sachinpullil/mecanum-robot-meam-5100/Images/motor-driver-circuit.png

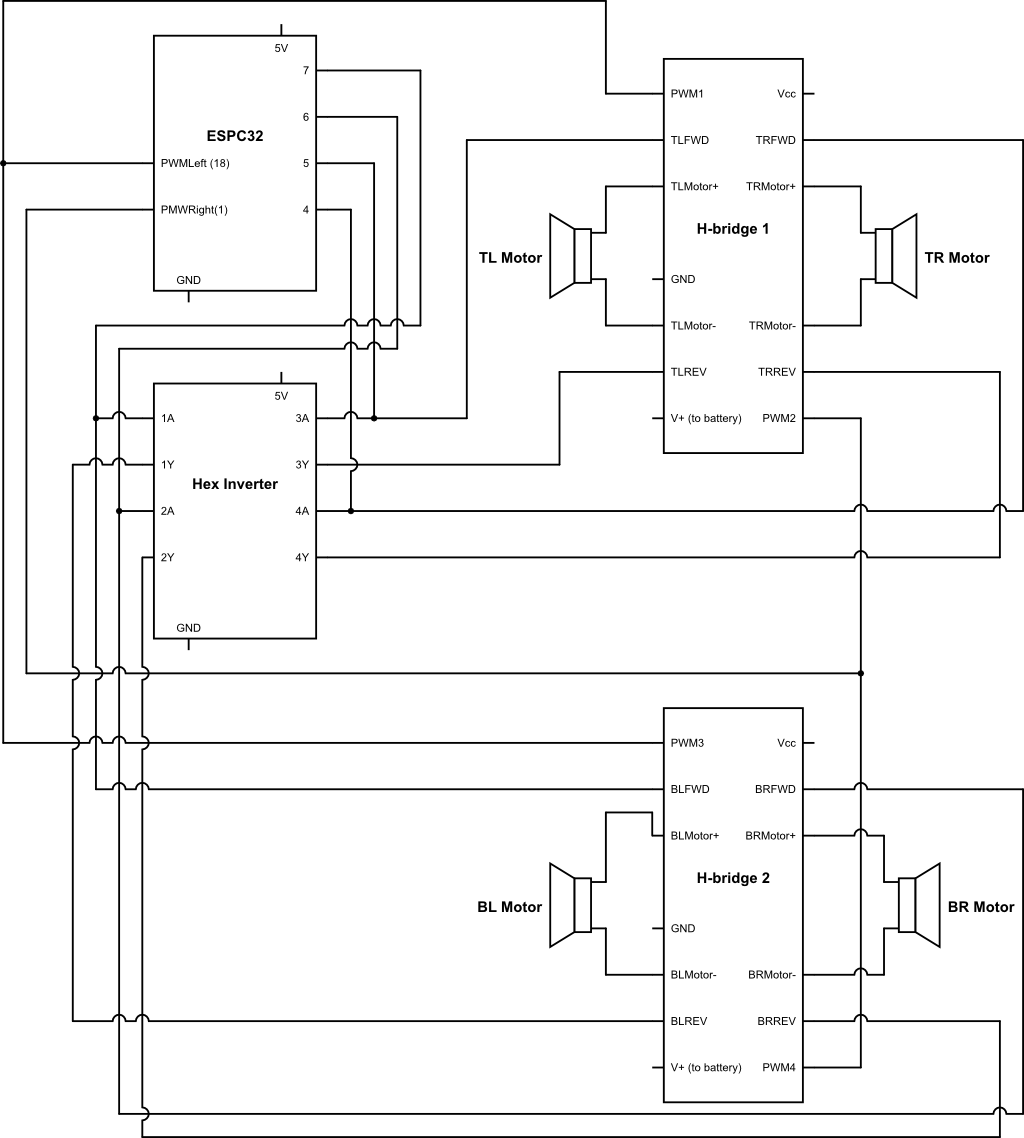
Images/motor-driver-circuit.png
