sachinpullil/mecanum-robot-meam-5100/Mecanum_robot_2.3_C3_MotorDriver/myi2csetup.h

/* i2c_slave_test - Example
 *  Slave i2c expecting slave ESP32 on i2c_master_test
 *  modified from 
   https://github.com/espressif/esp-idf/tree/master/examples/peripherals/i2c/i2c_self_test
   For other examples please check:
   https://github.com/espressif/esp-idf/tree/master/examples

    Attach SCL wire to GPIO 26, and  SDA to GPIO 25
   
   See README.md file to get detailed usage of this example.
   This example code is in the Public Domain (or CC0 licensed, at your option.)
   Unless required by applicable law or agreed to in writing, this
   software is distributed on an "AS IS" BASIS, WITHOUT WARRANTIES OR
   CONDITIONS OF ANY KIND, either express or implied.
*/
#include <stdio.h>
#include "esp_log.h"
#include "driver/i2c.h"
#include "sdkconfig.h"

#define DATA_LENGTH 128                  /*!< Data buffer length of test buffer */
#define RW_TEST_LENGTH 22               /*!< Data length for r/w test, [0,DATA_LENGTH] */

#define I2C_SLAVE_SCL_IO (gpio_num_t)4               /*!< gpio number for i2c slave clock */
#define I2C_SLAVE_SDA_IO (gpio_num_t)5               /*!< gpio number for i2c slave data */
#define I2C_SLAVE_TX_BUF_LEN (2* DATA_LENGTH)              /*!< I2C slave tx buffer size */
#define I2C_SLAVE_RX_BUF_LEN (2 * DATA_LENGTH)              /*!< I2C slave rx buffer size */

#define ESP_SLAVE_ADDR       0x28 /*!< ESP32 slave address, you can set any 7bit value */

#define C3_SCL_GPIO 0
#define C3_SDA_GPIO 19


/**
 * @brief i2c slave initialization
 */
static esp_err_t i2c_slave_init()
{
    i2c_port_t i2c_slave_port = I2C_NUM_0;
    i2c_config_t conf_slave;
    conf_slave.sda_io_num = C3_SDA_GPIO;                    //I2C_SLAVE_SDA_IO;
    conf_slave.sda_pullup_en = GPIO_PULLUP_ENABLE;
    conf_slave.scl_io_num = C3_SCL_GPIO;                    //I2C_SLAVE_SCL_IO;
    conf_slave.scl_pullup_en = GPIO_PULLUP_ENABLE;
    conf_slave.mode = I2C_MODE_SLAVE;
    conf_slave.slave.addr_10bit_en = 0;
    conf_slave.slave.slave_addr = ESP_SLAVE_ADDR;
    i2c_param_config(i2c_slave_port, &conf_slave);
    return i2c_driver_install(i2c_slave_port, conf_slave.mode,
                              I2C_SLAVE_RX_BUF_LEN,
                              I2C_SLAVE_TX_BUF_LEN, 0);
}

typedef struct MotorControlMessage {
    char cDir;
    int nLeftPowerPercent;
    int nRightPowerPercent;
} MotorControlMessage;

MotorControlMessage receivedData;

//Internal stores of the message variables
char _cDir = '0';
int _nLeftPowerPercent = 0;
int _nRightPowerPercent = 0;
